lahirunirmalx/astable-multivibrator/docs/check_schematic_report.md

# check-schematic report - astable_multivibrator (2026-10-20)

Input: `kicad/astable_multivibrator/astable_multivibrator.kicad_sch` (generated by draw-schematic pipeline, ok=True)
Analysis dir: `analysis/2026-10-20_1046/`

## Checklist

```
--- check-schematic ran ---
OK  ERC (kicad-cli)            0 errors / 0 warnings (after project fp/sym lib tables)
OK  draw-schematic L3 topology 12 / 12 nets match the .py source (40 pin nodes)
OK  analyze_schematic          findings: BLOCKER 0 / CRITICAL 0 / HIGH 0 / error 1 (SS-001) / warning 1 (RS-001) / info 13
OK  simulate_subcircuits       pass 4 / warn 0 / fail 0 / skip 0  (RC networks only; tool does not model the astable)
OK  aa_filter_sim              0 candidates (no ADC chain in this design)
OK  full-circuit ngspice       docs/astable_fullcircuit.cir (generic 2N3904-class model, red LED model)
SKIP Monte Carlo               not requested
SKIP datasheet pin-level       no MPN chosen on purpose (jellybean build); hybrid footprint pad map checked by hand instead
--- verdict ---
pass  next: draw-pcb (Phase 4)
```

## Findings triage

| rule | severity | what | decision |
|---|---|---|---|
| SS-001 | error | 0 of 7 BOM lines carry an MPN | accepted by design: every line is a generic value-only part (R, C, LED, GP NPN, pin header, copper jumper). Section 5 of CLAUDE.md records the spec per role. Not a fab blocker for a hobby board; production assembly would need MPNs. |
| RS-001 | warning | VCC has no PWR_FLAG / source pin | J1 is a passive 1x2 header; ERC itself is clean. No action. |
| PL-001 | info | Q1/Q2 drive LEDs without sense resistor | R1/R4 (470 R) are the current limit; the detector expected a PWM dimmer topology. No action. |
| SJ-DET x4 | info | solder jumpers detected | expected (pinout select). |
| TR-DET x2, RC-DET x2, LA-AUD x2, DS-003 | info | structure detected | expected. |

## Full-circuit transient (ngspice 1 ms step, 4 s)

| supply | period | freq | LED peak current | base negative swing | note |
|---|---|---|---|---|---|
| 5 V | 0.545 s | 1.83 Hz | 7.0 mA | -2.9 V | within V_EBO of any GP NPN |
| 9 V | 0.590 s | 1.70 Hz | 15.3 mA | -6.9 V (model has no E-B breakdown) | real part avalanches at about -6 V each half cycle; classic-kit behaviour, LED current stays under 20 mA |

Analytic check: half period = Rb * C * ln((Vcc + Vswing) / (Vcc - 0.7)) with Vswing = Vcc - Vf_LED - Vce_sat
(5 V: 47k * 10u * ln(7.3 / 4.3) = 0.249 s -> 0.50 s period; sim 0.545 s, within model tolerance).
The frequency is lower than the textbook 1.386 * Rb * C value because the LED drop reduces the collector swing.

## Verification gaps (stated, not hidden)

- Transistor and LED SPICE models are generic, not datasheet-derived.
- E-B reverse breakdown is not modelled; the 9 V figures are therefore optimistic on timing.
- No datasheet cross-check (no MPN).
