lahirunirmalx/astable-multivibrator/release/20261020_190434/pcb_fab/gerbers/astable_multivibrator-drill_report.txt

Drill report for astable_multivibrator.kicad_pcb
Created on 2026-10-20T15:34:35+0530

Copper Layer Stackup:
    =============================================================
    L1 :  F.Cu                      front
    L2 :  B.Cu                      back

Drill file 'astable_multivibrator.drl' contains
    plated through holes:
    =============================================================
    T1  0.300mm  0.0118"  (9 holes)
    T2  0.750mm  0.0295"  (6 holes)
    T3  0.800mm  0.0315"  (12 holes)
    T4  0.900mm  0.0354"  (4 holes)
    T5  1.000mm  0.0394"  (2 holes)

    Total plated holes count 33

Not plated through holes are merged with plated holes
    unplated through holes:
    =============================================================

    Total unplated holes count 0
