lahirunirmalx/astable-multivibrator/STATUS.md

# astable_multivibrator — STATUS

> live state；决策见 `CLAUDE.md`（静态）；决定理由见 `_artifacts/decisions/`（按需建）
> 最后更新：2026-10-20

## 阶段进度

| Phase | 状态 | 完成日期 | 关键 artifact |
|---|---|---|---|
| 0 骨架 | ✅ | 2026-10-20 | 本目录 + `CLAUDE.md` 模板 + `STATUS.md` + `.gitignore`（project-init 产出）|
| 1 拓扑 | ✅ | 2026-10-20 | `CLAUDE.md` sections 1-9 (classic astable, hybrid footprints, pinout jumpers) |
| 2 选品 | ✅ (skipped) | 2026-10-20 | all parts generic jellybeans, no shortlist needed |
| 2.5 落资产 | ✅ | 2026-10-20 | `~/tools/PCB-Agent-Teams/lib_external/Hybrid.pretty` + `Hybrid.kicad_sym`; `datasheets/.bom_readiness.json` all_pass (15/15 generic) |
| 3 sch 生成 | ✅ | 2026-10-20 | `kicad/astable_multivibrator/astable_multivibrator.kicad_sch` + .pdf; ERC 0 err / 0 warn, L3 12/12 nets, L4 footprints ok |
| 3.5 sch 检查 | ✅ | 2026-10-20 | `analysis/2026-10-20_1046/` + `docs/check_schematic_report.md` (ngspice 1.8 Hz @ 5 V, 7 mA LED) |
| 4 pcb 生成 | ✅ | 2026-10-20 | `kicad/astable_multivibrator/astable_multivibrator.kicad_pcb` (26.15 x 21.73 mm, Freerouting, GND pour both sides, 7 stitch vias, DRC 0 err / 0 warn / 0 unconnected); placed-only board `astable_multivibrator_placed.kicad_pcb`; panel `kicad/panel/astable_multivibrator_panel.kicad_pcb` (2x4, 110.3 x 59.4 mm, DRC clean) |
| 4.5 pcb 检查 | ✅ | 2026-10-20 | `analysis/2026-10-20_1046/{pcb,cross_analysis,thermal,emc,gerber}.json` + `docs/check_pcb_report.md` (pass, all findings triaged) |
| 5 release | ✅ | 2026-10-20 | `release/20261020_190434/` (release umbrella: fab zip, CPL, assembly BOM, procurement CSVs, ORDER_GUIDE) + `release/astable_multivibrator_gerbers_panel_2x4.zip` + `release/PCBWAY_ORDER.md` (user chose PCBWay, PCB only) |

## 当前 blocker

- user confirmation of CLAUDE.md section 9 assumptions (pinout-jumper reading, hybrid reading, 2x4 panel); then `release` umbrella if a vendor order package is wanted

## 已产出 artifact 索引

- ✅ `CLAUDE.md` 模板（2026-10-20，待 Phase 1 填实）
- ✅ `STATUS.md` 本文件（2026-10-20）
- ✅ `.gitignore`

## Change log（append-only，含回退）

- **2026-10-20**: Phase 0 - project-init skeleton (5 subdirs + .gitignore + CLAUDE.md template + this file)
- **2026-10-20**: Phase 1 - circuit frozen in CLAUDE.md (2N-style astable, 470R/47k/10uF, ~1.5 Hz). Hybrid footprint lib `~/electronics/lib_external/Hybrid.pretty` (4 footprints) + `Hybrid.kicad_sym` (5-pin NPN) generated by `kicad/tools/build_hybrid_footprints.py`; scratch-board DRC: 0 errors.
- **2026-10-20**: Phase 2.5 - check_readiness all_pass (generic mode). Phase 3 - pipeline.py ok=True (ERC 0/0 after project lib tables, L3 topology 12/12). Skill script patches: `verify_topology.py` (kicad-cli path + KiCad 9 netlist parsing), `check_readiness.py` (Device:Q_* / Jumper: / Hybrid: generic classification).
- **2026-10-20**: Phase 3.5 - check-schematic pass (SS-001 no-MPN accepted by design; full-circuit ngspice 1.83 Hz / 7 mA at 5 V, 1.70 Hz / 15 mA at 9 V).
- **2026-10-20**: Phase 4 - draw-pcb loop: 1 placement round (hand plan, mirror-symmetric 3 columns), route-ready 10/10, refit 26.05 x 21.64 mm fill 0.63. Phase E routed with **Freerouting 1.9.0** (user request; new skill tool `draw-pcb/scripts/tools/route_freerouting.py`, now the default engine in SKILL.md). Re-pour (GND,B.Cu)+(GND,F.Cu), 7 stitch vias, silk tidied (`kicad/tools/silk_tidy.py`: outlines crossing SMD lands moved to F.Fab, refs pinned, JP refs on F.Fab). Final DRC 0/0/0. KiKit panel 2x4 (`kicad/panel/`), DRC clean after mouse-bite spacing 1.0 mm / offset 0.
- **2026-10-20**: Phase 4.5 - check-pcb pass (DRC 0/0/0, cross 0, EMC/thermal findings triaged as not applicable at 1.8 Hz). Gerbers + drill + CPL exported for board and 2x4 panel (`release/`), gerber audit GR-004 expected (THT no paste).
- **2026-10-20**: Phase 5 - release umbrella run (channel prefs auto_cheapest / any / stable_first recorded; user's actual fab choice PCBWay documented in release/PCBWAY_ORDER.md). Patched release/scripts/export_gerbers.py: `--check-zones` only on kicad-cli >= 10. Project symlinked into ~/tools/PCB-Agent-Teams/Projects/. Independent fab-artifact review launched (see docs/release_review.md).
- **2026-10-21**: v2 added (`kicad/astable_v2_single_layer/`): single-sided home-etch board, 62 x 72 mm, THT only, 1.0 mm tracks / 0.6 mm clearance, 2x3 header selection of Rb (22k/47k/100k) and C (4.7u/10u/47u) per stage, pinout select on 1x3 headers, 3 wire links (net-tie footprints, series sub-nets GND_W1 / GND_W2 / Q1_B_W3). New lib `kicad/lib/HomeEtch.pretty` + `AstableV2.kicad_sym`; generators `gen_v2_schematic.py`, `gen_v2_board.py`, `route_v2.py` (Freerouting with F.Cu rule area), `finalize_v2.py`. ERC 0/0, DRC 0 errors / 0 unconnected (silk warnings ignored by project rules), compare_netlist 82/82. ngspice 3x3 sweep in `docs/spice/`, CircuitJS link in `docs/circuitjs/`. Guide `docs/v2_home_etching.md`.
- **2026-10-21**: Hobby release prep. Hybrid lib vendored into `kicad/lib/` (lib tables now `${KIPRJMOD}/../lib/`), KiCad 3D models attached to the hybrid footprints (`kicad/tools/add_3d_models.py`), board footprints given the `Hybrid:` nickname. Schematic re-laid as a classic wired drawing (`kicad/tools/layout_schematic.py`, same symbol UUIDs, VCC/GND now power symbols + PWR_FLAG; board nets `/VCC` `/GND` renamed `VCC` `GND`, netclass patterns updated). Verified: ERC 0/0, DRC 0 errors + 10 `lib_footprint_mismatch` warnings (intentional silk-tidy local overrides), `compare_netlist.py` 40/40 pins match. Panel regenerated from the updated board; `kicad/panel/` now carries the lib tables too (DRC 0 errors / 80 `lib_footprint_mismatch` = 8 boards x the same 10 silk-tidy warnings). Renders in `images/`, STEP in `release/`, README + LICENSE (MIT) + docs/assembly.md rewritten. Release gerbers untouched (copper unchanged; their X2 net attributes still say `/VCC` `/GND`).
- **2026-10-20**: Phase 2 skipped (generic parts). Env: `~/.venv` and `~/lib_external` symlinked to `~/electronics/`; `verify_topology.py` and `check_readiness.py` skill scripts patched for Linux / generic symbols.

## 图例

| 符号 | 含义 |
|---|---|
| ✅ | done — phase 完成 + gate 通过 |
| 🟡 | in progress |
| ⛔ | pending — 还没开始 |
| ⚠ | stale — 上游改了，需重跑 |
| 🔄 | redoing — 用户回退中 |

## 回退处理 cheat sheet

用户喊 "Phase X 回退" 时按以下处理：

1. Phase X 当前行 append 一行 🔄 redoing（**不删历史**）
2. Phase X+1, X+2, ... 所有 ✅ 改成 ⚠ stale
3. 关联 sentinel 文件由下次 skill 跑时覆盖
4. 已存在的 .kicad_sch / .kicad_pcb 让 user 决定 git restore 还是覆盖
5. 在 Change log 新加一行说明回退原因
