lahirunirmalx/astable-multivibrator/release/20261020_190434/coverage_matrix.md

# Distributor 覆盖率矩阵
> 生成于 2026-10-20 19:04 JST
> 数据源：（无数据）

## 单 vendor 全覆盖

| Vendor | 覆盖率 | 推荐 |
|---|---|---|
| DigiKey JP | 0/0 | — |
| Mouser JP | 0/0 | — |
| LCSC | 0/0 | — |

## 详细矩阵

| MPN | Qty | Refs | DigiKey JP | Mouser JP | LCSC |
|---|---|---|---|---|---|

> ★ = component-preparing 选定的 primary winner（写进 `phase2.5_v1` evidence）
