lahirunirmalx/astable-multivibrator/images/v2/pcb_3d_bottom.png

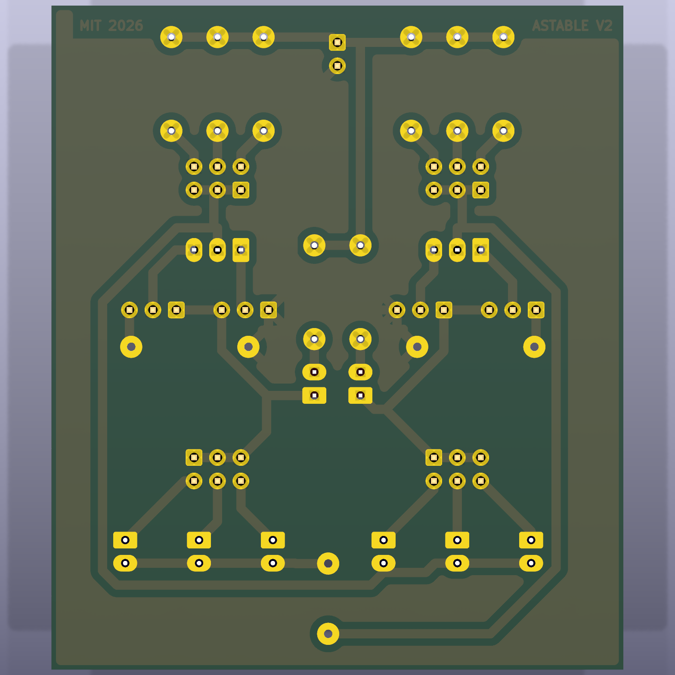
images/v2/pcb_3d_bottom.png
