lahirunirmalx/astable-multivibrator/images/v2/pcb_3d_top.png

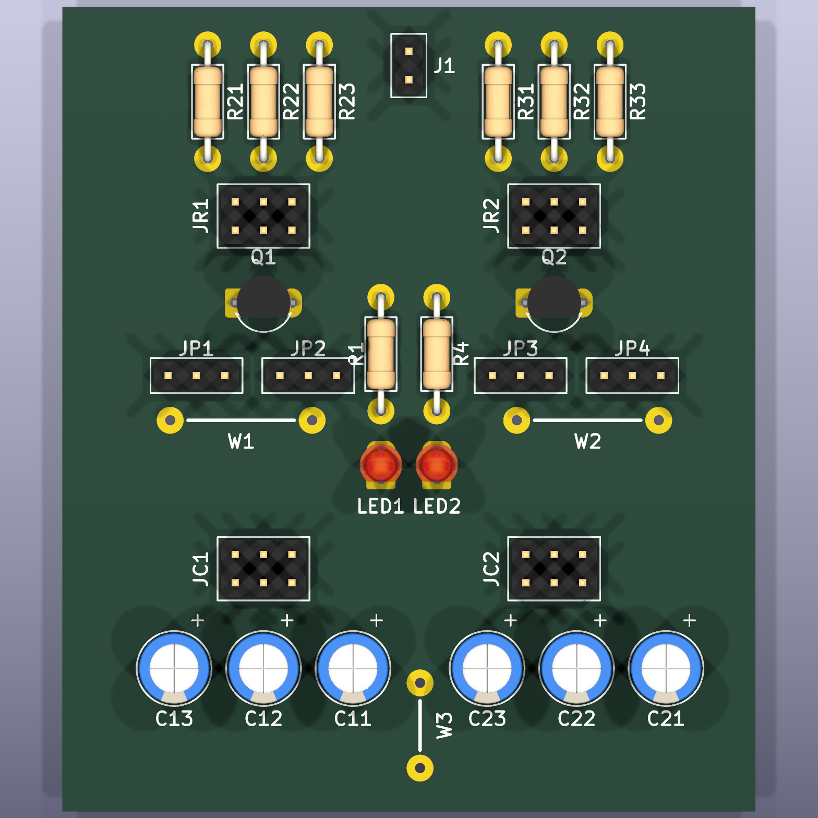
images/v2/pcb_3d_top.png
