lahirunirmalx/astable-multivibrator/images/v2/schematic.png

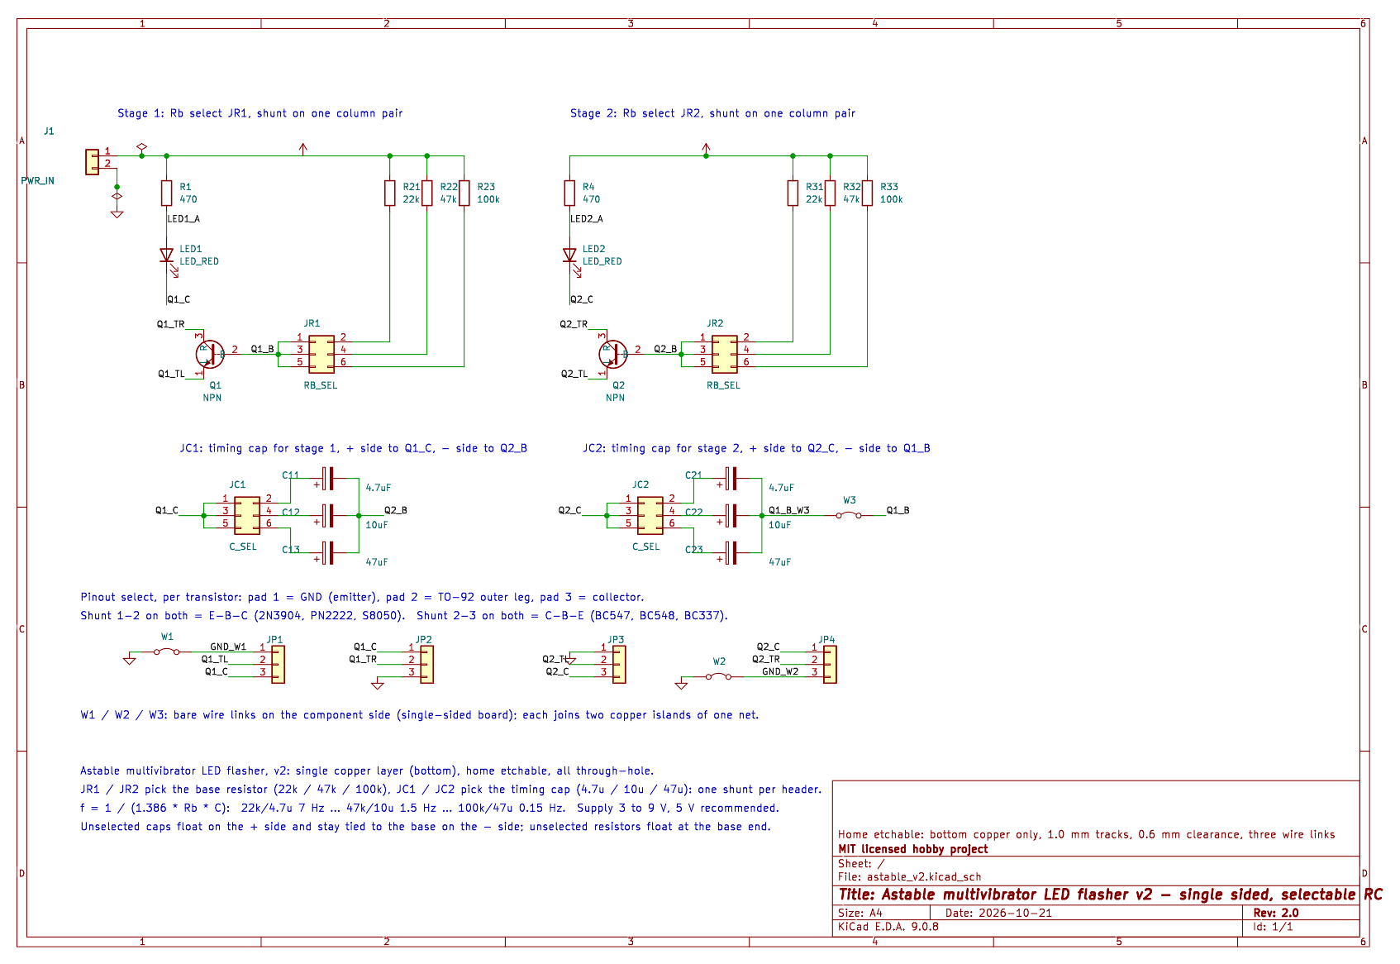
images/v2/schematic.png
