lahirunirmalx/astable-multivibrator/release/astable_multivibrator.step

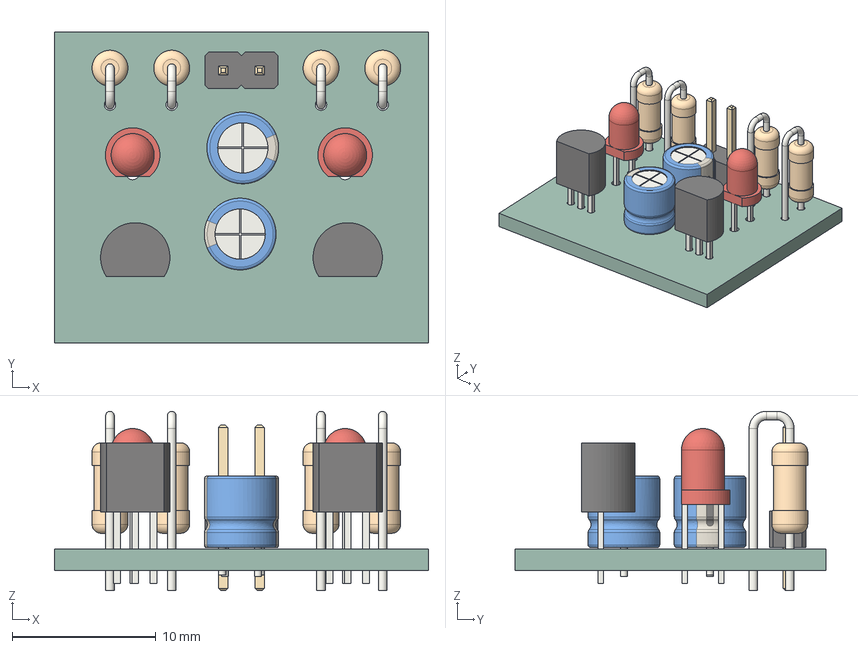
[picture p13: CAD file, 2026-10-21]
release/astable_multivibrator.step
26.0 x 21.6 x 12.5 mm
CP_Radial_D5.0mm_P2.50mm x 2
R_Axial_DIN0207_L6.3mm_D2.5mm_P2.54mm_Vertical x 4
PinHeader_1x02_P2.54mm_Vertical
LED_D3.0mm x 2
TO-92_Inline x 2
astable_multivibrator_PCB
