lahirunirmalx/astable-multivibrator/release/v2/astable_v2.step

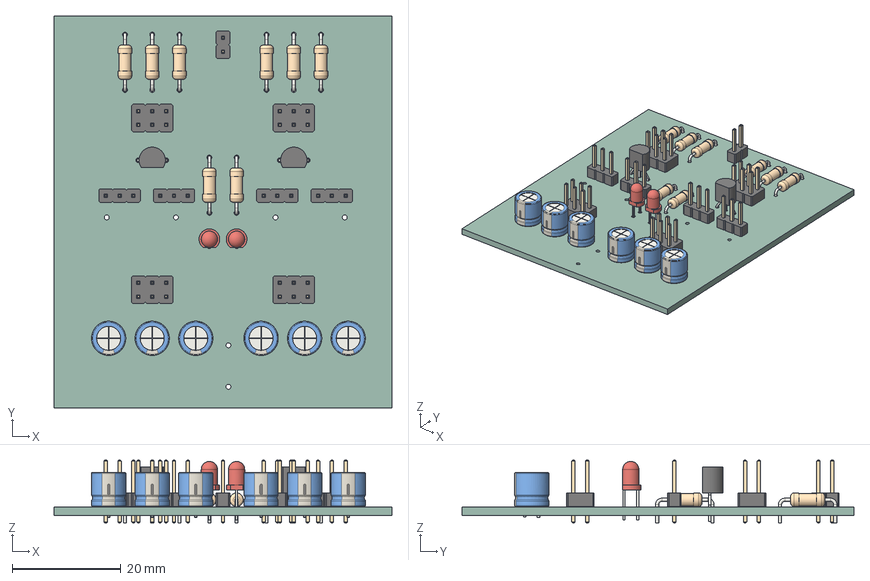
[picture p14: CAD file, 2026-10-21]
release/v2/astable_v2.step
62.0 x 72.0 x 11.5 mm
TO-92_Inline_Wide x 2
PinHeader_1x03_P2.54mm_Vertical x 4
PinHeader_2x03_P2.54mm_Vertical x 4
CP_Radial_D6.3mm_P2.50mm x 6
R_Axial_DIN0207_L6.3mm_D2.5mm_P10.16mm_Horizontal x 8
PinHeader_1x02_P2.54mm_Vertical
LED_D3.0mm x 2
astable_v2_PCB
