lahirunirmalx/astable-multivibrator/images/v2/assembly_top.png

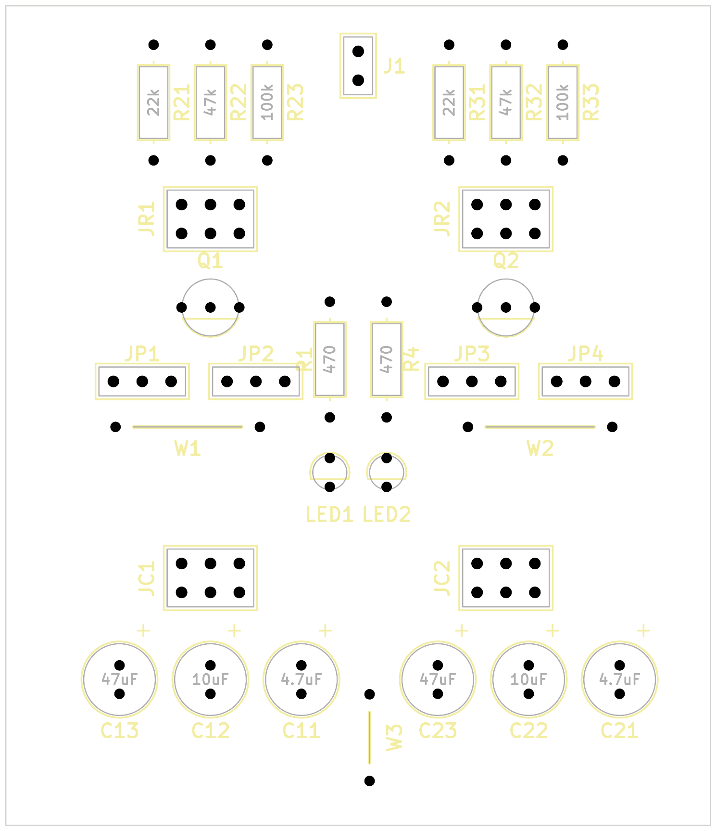
images/v2/assembly_top.png
