lahirunirmalx/astable-multivibrator/docs/astable_v2_schematic.pdf

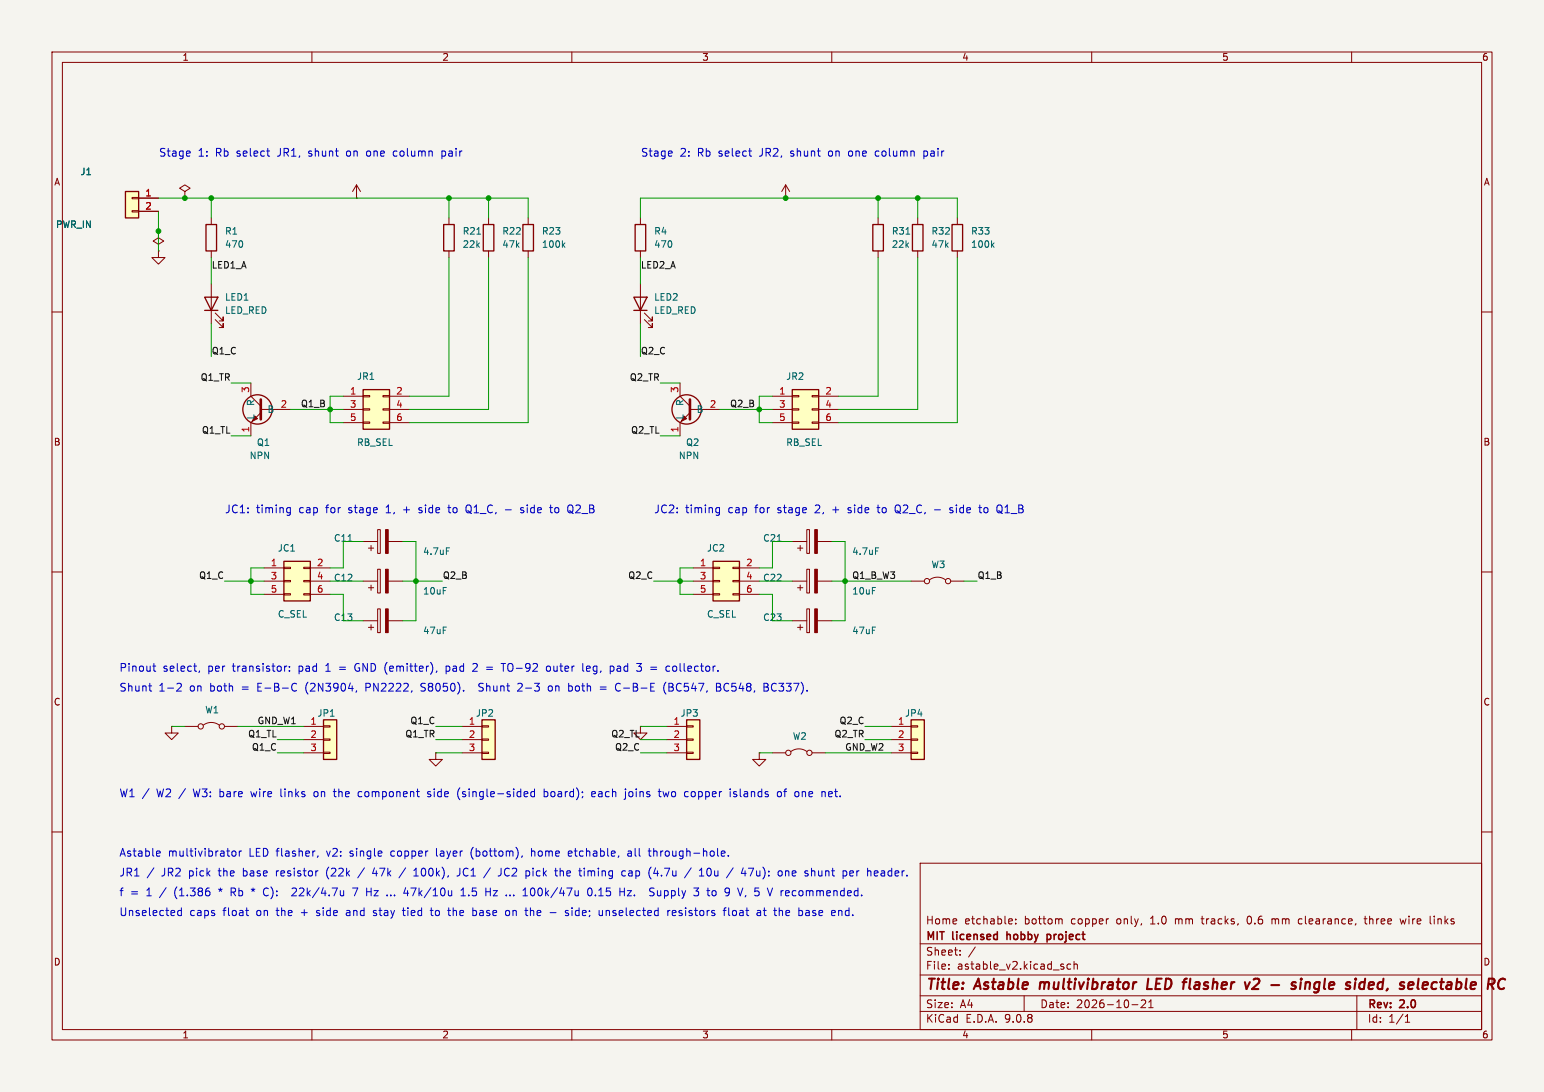
[picture p16: page 1]

Stage 2: Rb select JR2, shunt on one column pair JC2: timing cap for stage 2, + side to Q2_C, - side to Q1_B

JC1: timing cap for stage 1, + side to Q1_C, - side to Q2_B
