lahirunirmalx/astable-multivibrator/docs/astable_multivibrator_schematic.pdf

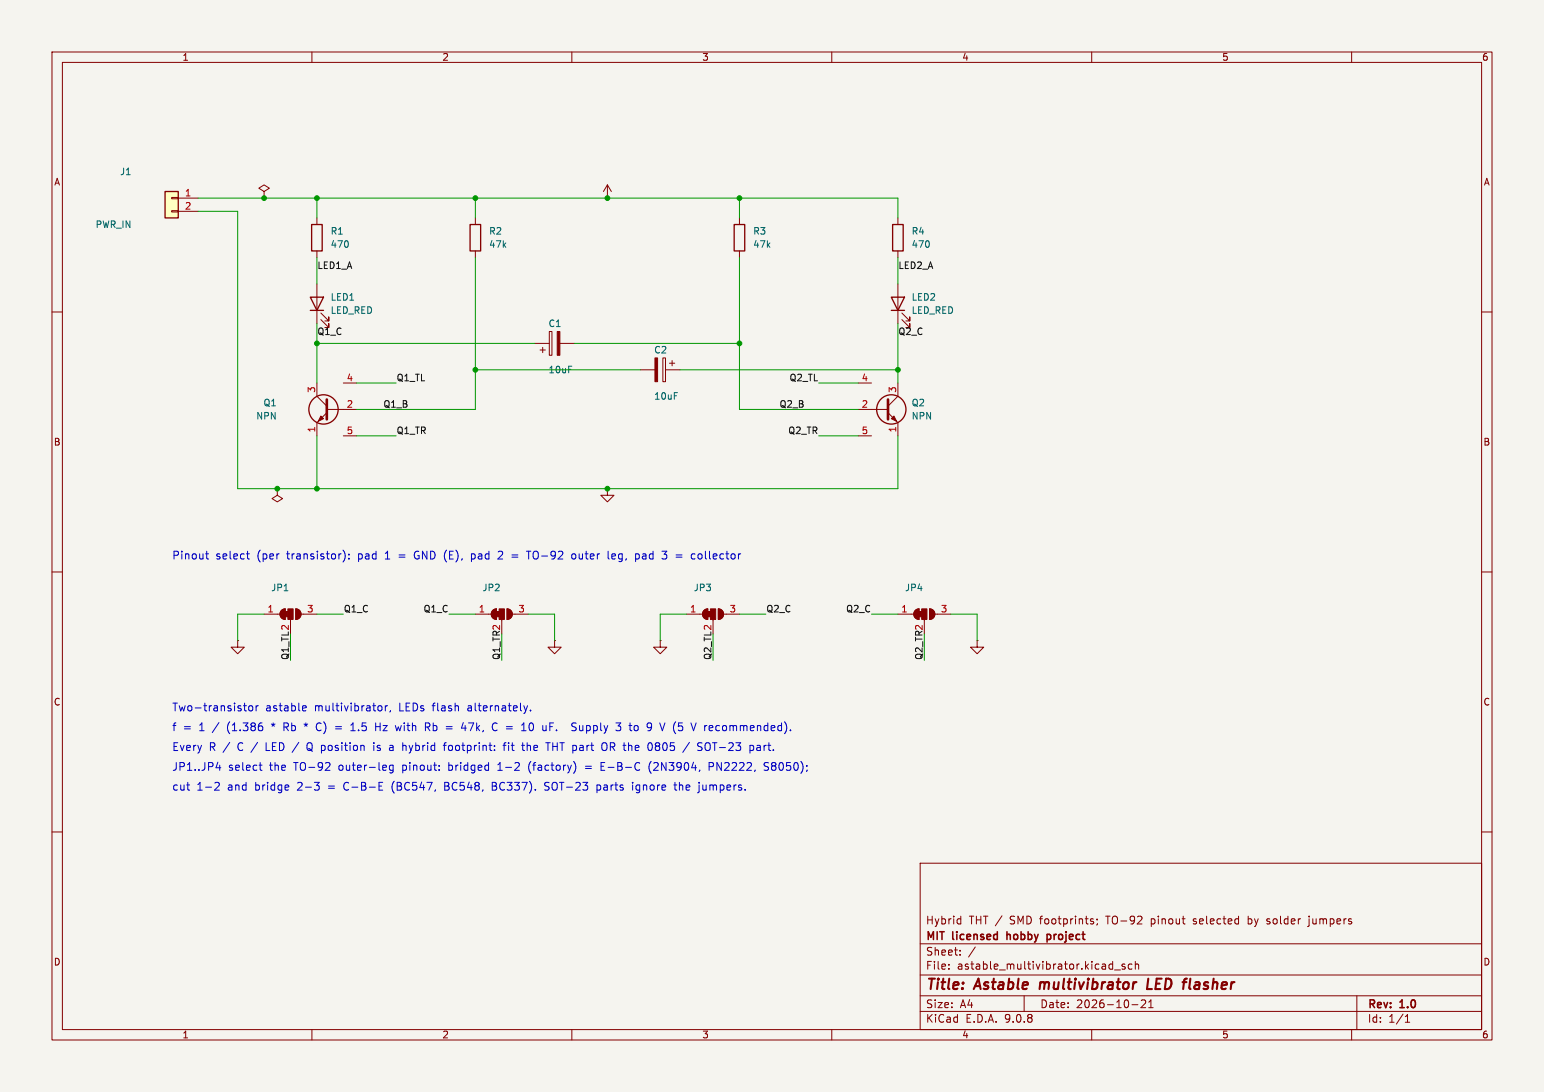
[picture p17: page 1]
