lahirunirmalx/astable-multivibrator/release/v2/astable_v2_assembly_top.pdf

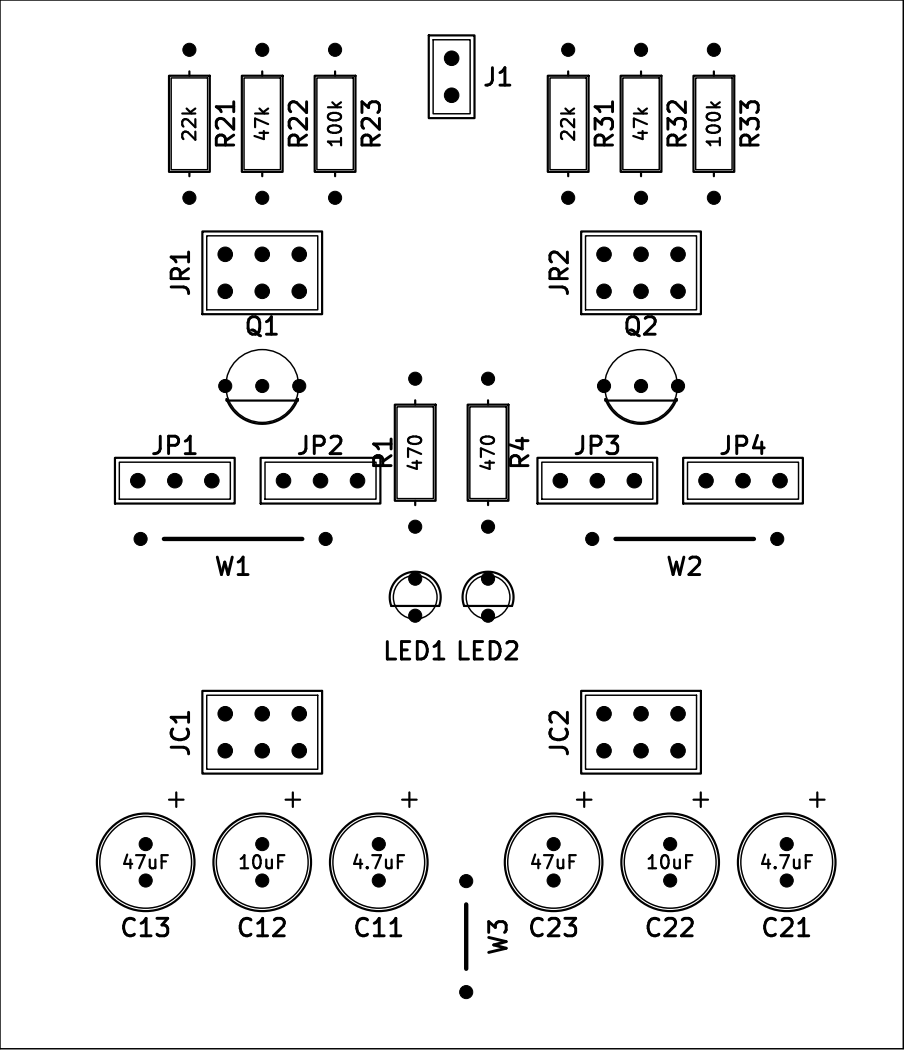
[picture p18: page 1]
