lahirunirmalx/astable-multivibrator/release/v2/astable_v2_copper_toner_transfer_print_as_is.pdf

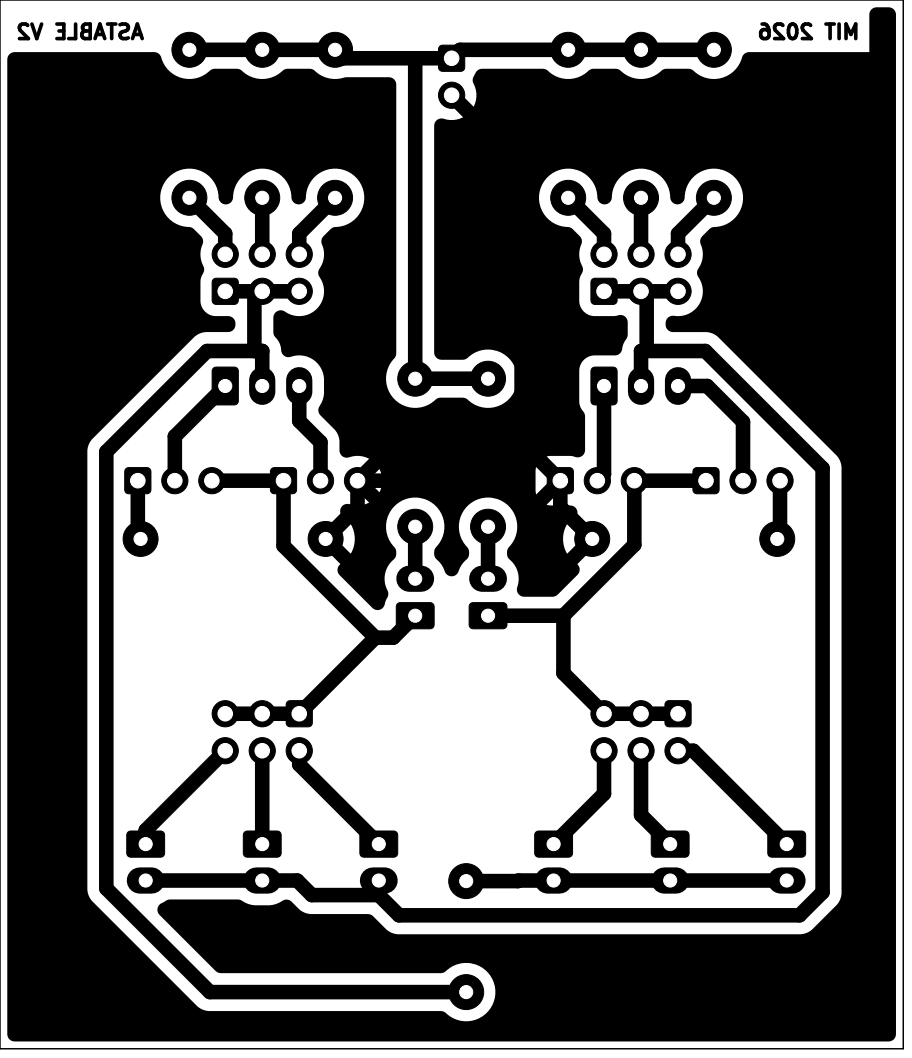
[picture p19: page 1]
