lahirunirmalx/astable-multivibrator/release/v2/astable_v2_copper_mirrored_for_photoresist.pdf

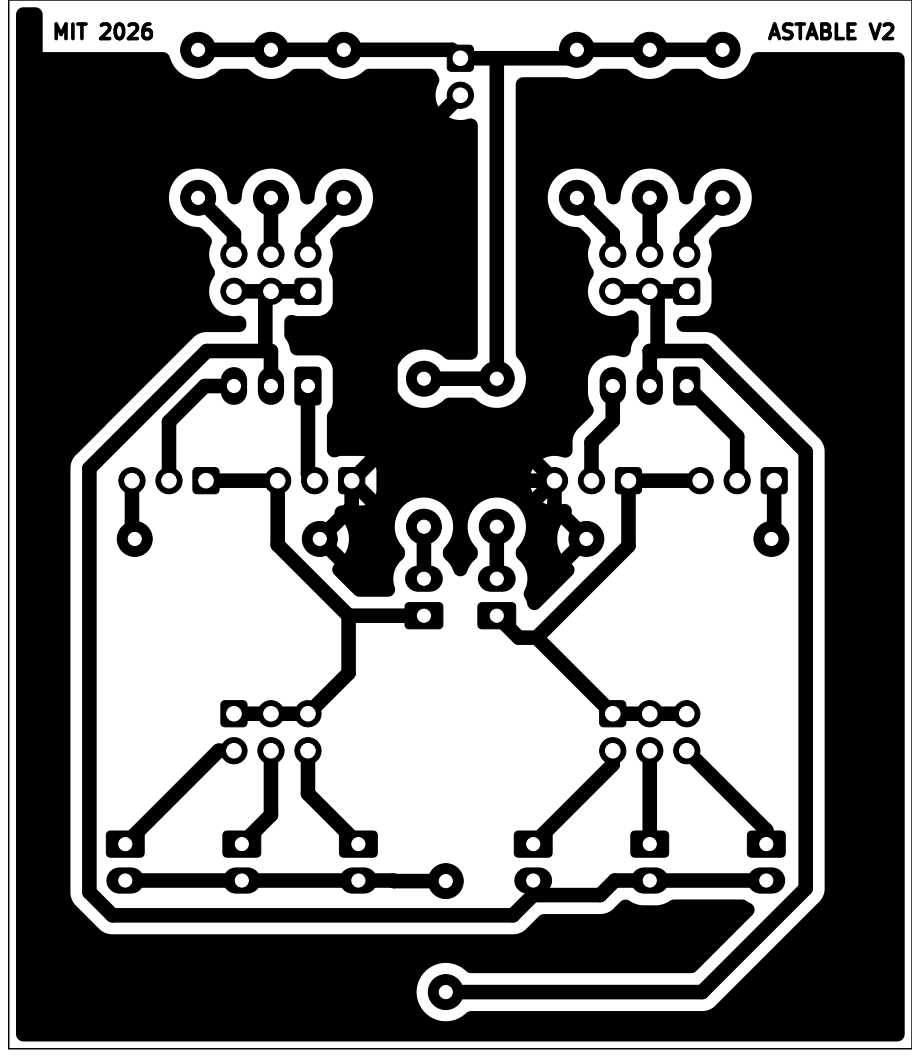
[picture p20: page 1]
