lahirunirmalx/astable-multivibrator/kicad/astable_v2_single_layer/astable_v2.kicad_pcb

## KiCad design kicad/astable_v2_single_layer/astable_v2.kicad_pcb (2026-10-21)

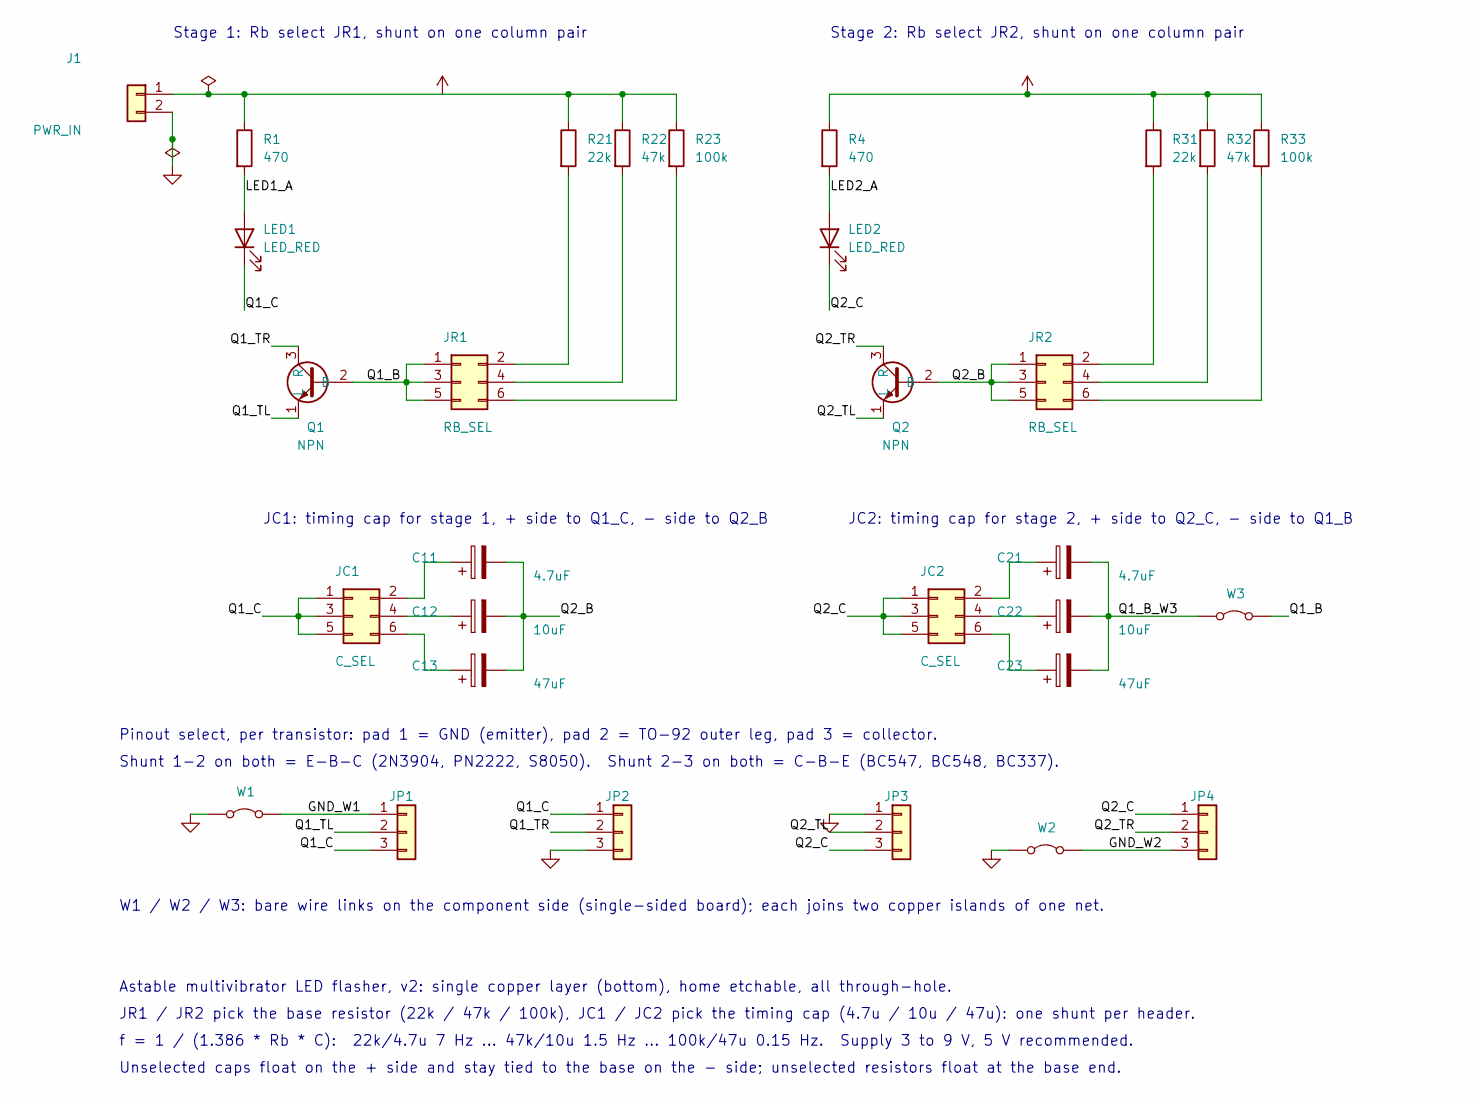
[picture p21: schematic astable_v2.kicad_sch, Astable multivibrator LED flasher v2 - single sided, select…]

Parts:
C11, C21: 4.7uF; CP_Radial_D6.3mm_P2.50mm_HomeEtch
C12, C22: 10uF; CP_Radial_D6.3mm_P2.50mm_HomeEtch
C13, C23: 47uF; CP_Radial_D6.3mm_P2.50mm_HomeEtch
J1: PWR_IN; PinHeader_1x02_P2.54mm_HomeEtch
JC1, JC2: C_SEL; PinHeader_2x03_P2.54mm_HomeEtch
JP1, JP2, JP3, JP4: PINOUT; PinHeader_1x03_P2.54mm_HomeEtch
JR1, JR2: RB_SEL; PinHeader_2x03_P2.54mm_HomeEtch
LED1, LED2: LED_RED; LED_D3.0mm_P2.54mm_HomeEtch
Q1, Q2: NPN; TO-92_P2.54mm_HomeEtch
R1, R4: 470; R_Axial_P10.16mm_HomeEtch
R21, R31: 22k; R_Axial_P10.16mm_HomeEtch
R22, R32: 47k; R_Axial_P10.16mm_HomeEtch
R23, R33: 100k; R_Axial_P10.16mm_HomeEtch
W1, W2: WIRE_LINK; WireLink_P12.70mm_HomeEtch
W3: WIRE_LINK; WireLink_P7.62mm_HomeEtch

Connections:
/GND_W1: JP1.1, W1.2 (B)
/GND_W2: JP4.3, W2.2 (B)
/LED1_A: LED1.2 (A), R1.2
/LED2_A: LED2.2 (A), R4.2
/Q1_B: JR1.1, JR1.3, JR1.5, Q1.2 (B), W3.2 (B)
/Q1_B_W3: C21.2, C22.2, C23.2, W3.1 (A)
/Q1_C: JC1.1, JC1.3, JC1.5, JP1.3, JP2.1, LED1.1 (K)
/Q1_TL: JP1.2, Q1.1 (L)
/Q1_TR: JP2.2, Q1.3 (R)
/Q2_B: C11.2, C12.2, C13.2, JR2.1, JR2.3, JR2.5, Q2.2 (B)
/Q2_C: JC2.1, JC2.3, JC2.5, JP3.3, JP4.1, LED2.1 (K)
/Q2_TL: JP3.2, Q2.1 (L)
/Q2_TR: JP4.2, Q2.3 (R)
GND: J1.2, JP2.3, JP3.1, W1.1 (A), W2.1 (A)
unnamed: C11.1, JC1.2
unnamed: C12.1, JC1.4
unnamed: C13.1, JC1.6
unnamed: C21.1, JC2.2
unnamed: C22.1, JC2.4
unnamed: C23.1, JC2.6
unnamed: JR1.2, R21.2
unnamed: JR1.4, R22.2
unnamed: JR1.6, R23.2
unnamed: JR2.2, R31.2
unnamed: JR2.4, R32.2
unnamed: JR2.6, R33.2
VCC: J1.1, R1.1, R4.1, R21.1, R22.1, R23.1, R31.1, R32.1, R33.1

Notes on the sheet:
Stage 1: Rb select JR1, shunt on one column pair
Stage 2: Rb select JR2, shunt on one column pair
JC1: timing cap for stage 1, + side to Q1_C, - side to Q2_B
JC2: timing cap for stage 2, + side to Q2_C, - side to Q1_B
Pinout select, per transistor: pad 1 = GND (emitter), pad 2 = TO-92 outer leg, pad 3 = collector.
Shunt 1-2 on both = E-B-C (2N3904, PN2222, S8050). Shunt 2-3 on both = C-B-E (BC547, BC548, BC337).
W1 / W2 / W3: bare wire links on the component side (single-sided board); each joins two copper islands of one net.
Astable multivibrator LED flasher, v2: single copper layer (bottom), home etchable, all through-hole.
JR1 / JR2 pick the base resistor (22k / 47k / 100k), JC1 / JC2 pick the timing cap (4.7u / 10u / 47u): one shunt per header.
f = 1 / (1.386 * Rb * C): 22k/4.7u 7 Hz ... 47k/10u 1.5 Hz ... 100k/47u 0.15 Hz. Supply 3 to 9 V, 5 V recommended.
Unselected caps float on the + side and stay tied to the base on the - side; unselected resistors float at the base end.

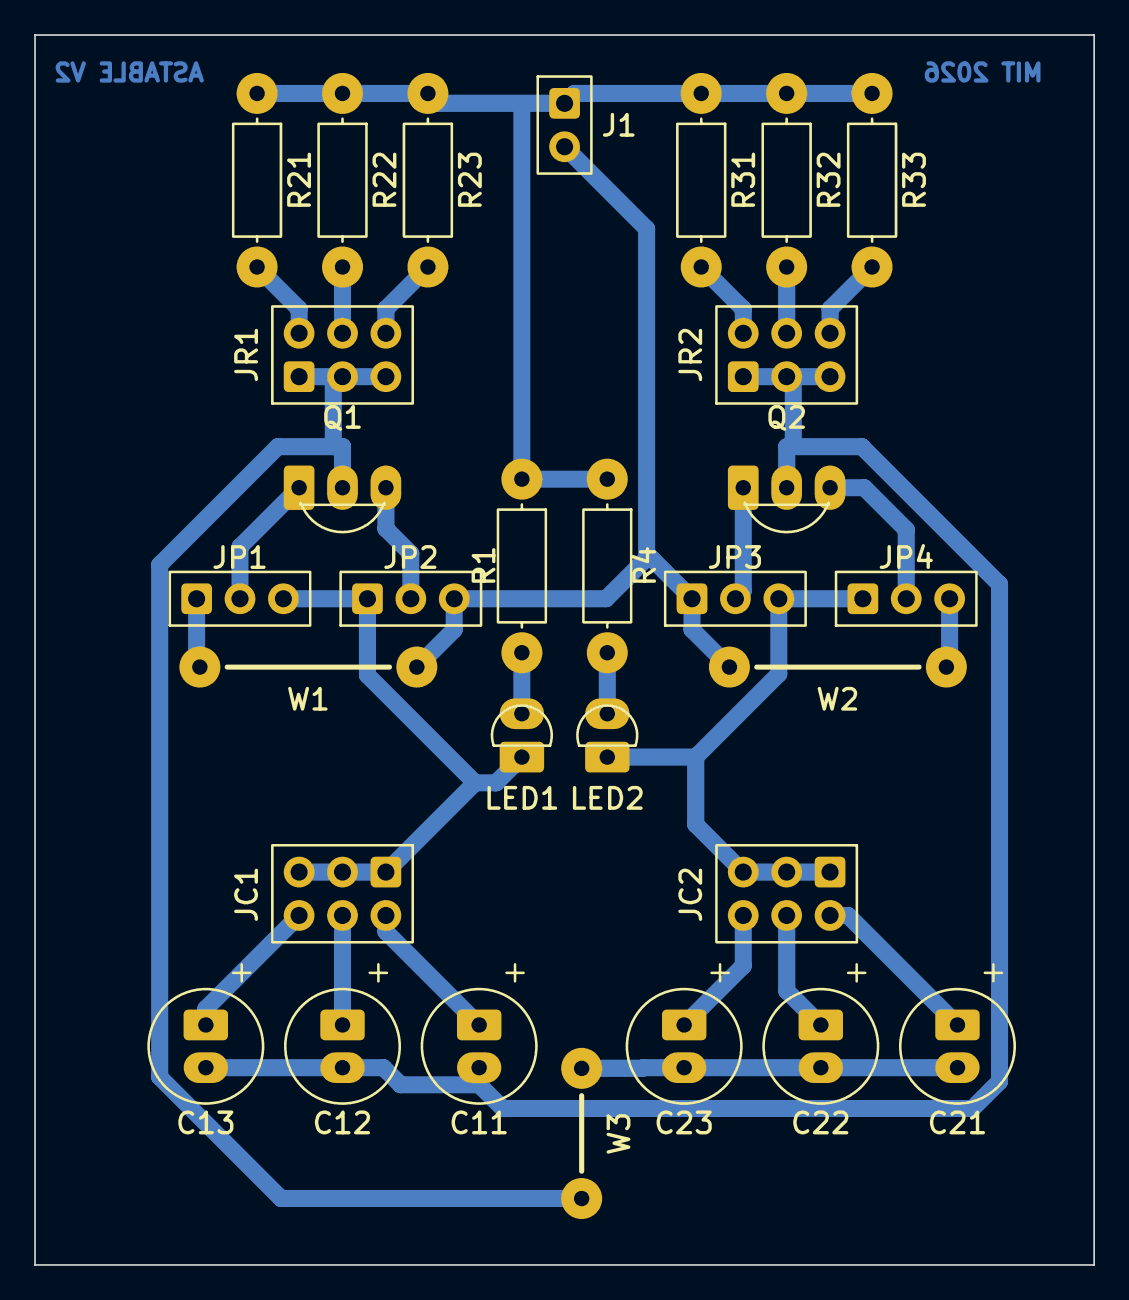
[picture p22: board astable_v2.kicad_pcb from above]

Board: 2 copper layers, 62.0 x 72.0 mm, 30 parts (0 on the bottom side), 27 nets.
