lahirunirmalx/astable-multivibrator/kicad/astable_multivibrator/astable_multivibrator.kicad_pcb

## KiCad design kicad/astable_multivibrator/astable_multivibrator.kicad_pcb (2026-10-21)

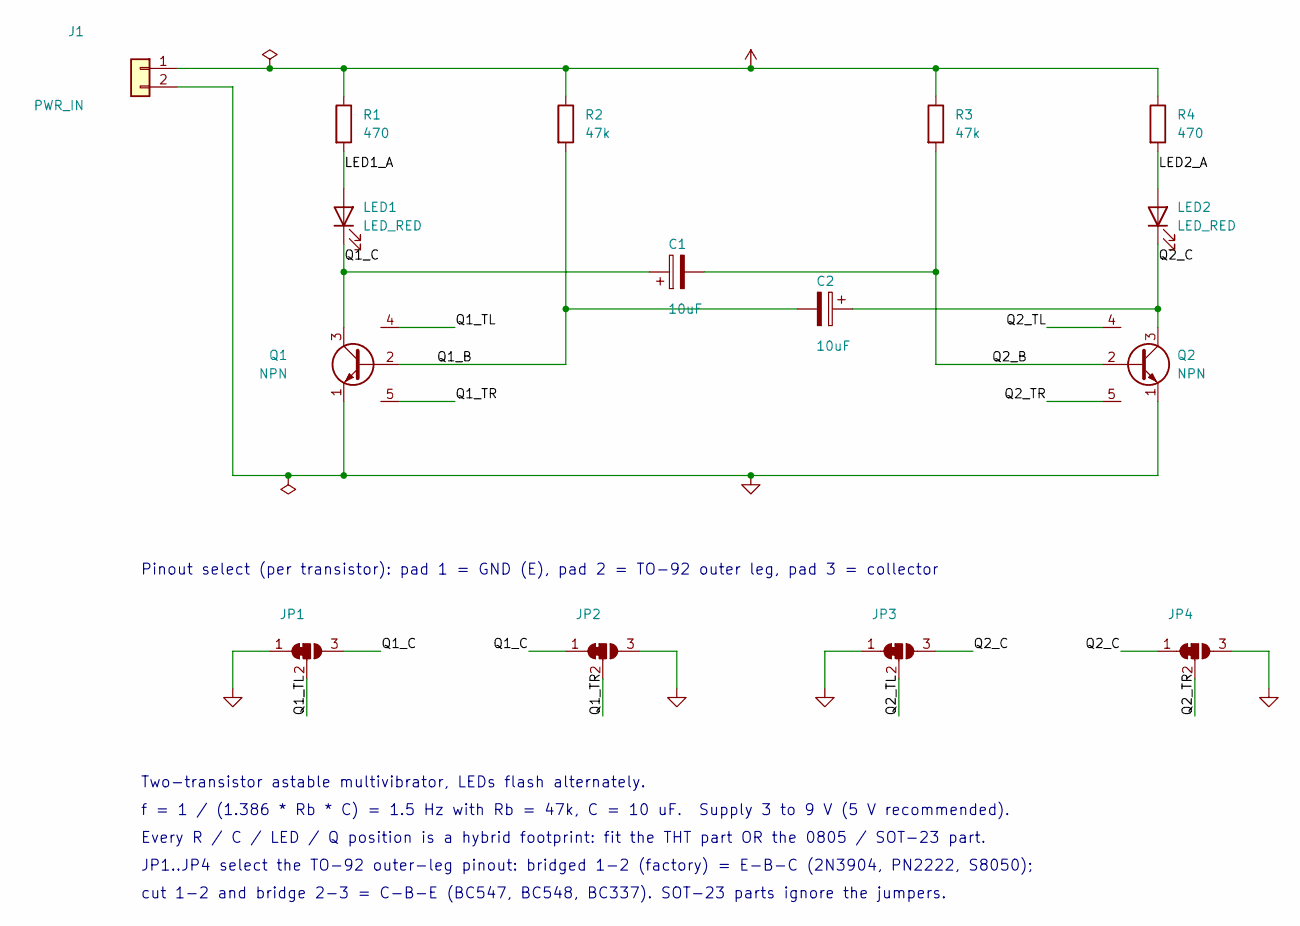
[picture p23: schematic astable_multivibrator.kicad_sch, Astable multivibrator LED flasher]

Parts:
C1, C2: 10uF; CP_Hybrid_0805_D5.0mm_P2.50mm
J1: PWR_IN; PinHeader_1x02_P2.54mm_Vertical
JP1, JP2, JP3, JP4: PINOUT; SolderJumper-3_P1.3mm_Bridged12_RoundedPad1.0x1.5mm
LED1, LED2: LED_RED; LED_Hybrid_0805_D3.0mm
Q1, Q2: NPN; Q_NPN_Hybrid_TO-92_SOT-23
R1, R4: 470; R_Hybrid_0805_P2.54_Vertical
R2, R3: 47k; R_Hybrid_0805_P2.54_Vertical

Connections:
/LED1_A: LED1.2 (A), R1.2
/LED2_A: LED2.2 (A), R4.2
/Q1_B: C2.2, Q1.2 (B), R2.2
/Q1_C: C1.1, JP1.3 (B), JP2.1 (A), LED1.1 (K), Q1.3 (C)
/Q1_TL: JP1.2 (C), Q1.4 (TL)
/Q1_TR: JP2.2 (C), Q1.5 (TR)
/Q2_B: C1.2, Q2.2 (B), R3.2
/Q2_C: C2.1, JP3.3 (B), JP4.1 (A), LED2.1 (K), Q2.3 (C)
/Q2_TL: JP3.2 (C), Q2.4 (TL)
/Q2_TR: JP4.2 (C), Q2.5 (TR)
GND: J1.2, JP1.1 (A), JP2.3 (B), JP3.1 (A), JP4.3 (B), Q1.1 (E), Q2.1 (E)
VCC: J1.1, R1.1, R2.1, R3.1, R4.1

Notes on the sheet:
Two-transistor astable multivibrator, LEDs flash alternately.
f = 1 / (1.386 * Rb * C) = 1.5 Hz with Rb = 47k, C = 10 uF. Supply 3 to 9 V (5 V recommended).
Every R / C / LED / Q position is a hybrid footprint: fit the THT part OR the 0805 / SOT-23 part.
JP1..JP4 select the TO-92 outer-leg pinout: bridged 1-2 (factory) = E-B-C (2N3904, PN2222, S8050);
cut 1-2 and bridge 2-3 = C-B-E (BC547, BC548, BC337). SOT-23 parts ignore the jumpers.
Pinout select (per transistor): pad 1 = GND (E), pad 2 = TO-92 outer leg, pad 3 = collector

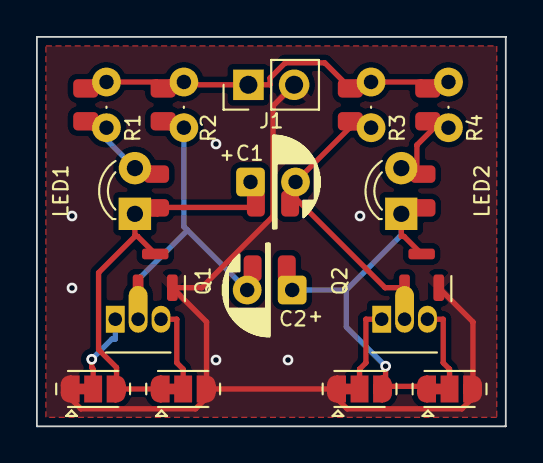
[picture p24: board astable_multivibrator.kicad_pcb from above]

Board: 2 copper layers, 26.0 x 21.6 mm, 15 parts (0 on the bottom side), 12 nets.
