lahirunirmalx/astable-multivibrator/(commit log)

2026-10-21 Astable multivibrator LED flasher: KiCad 9 project, hybrid THT/SMD footprints, gerbers, docs, MIT license
    - Classic two-transistor astable with pinout-select solder jumpers for TO-92 E-B-C / C-B-E and SOT-23
    - Schematic re-laid as a wired drawing; ERC 0/0, DRC 0 errors, schematic vs board 40/40 pins
    - 3D models on the hybrid footprints, renders in images/, STEP and gerber zips in release/
    - README, assembly guide, 2x4 KiKit panel
    [astable_multivibrator-B_Cu.gbl, astable_multivibrator-B_Cu.gbr, astable_multivibrator-B_Mask.gbr, astable_multivibrator-B_Mask.gbs, astable_multivibrator-B_Paste.gbp, astable_multivibrator-B_Paste.gbr, astable_multivibrator-B_Silkscreen.gbo, astable_multivibrator-B_Silkscreen.gbr]
2026-10-21 v2: single-sided home-etch board with selectable RC timing, CircuitJS link
    - kicad/astable_v2_single_layer: bottom copper only, THT, 1.0 mm tracks / 0.6 mm clearance, GND pour
    - 2x3 headers select Rb (22k/47k/100k) and C (4.7u/10u/47u) per stage, 1x3 headers for TO-92 pinout
    - three wire links modelled as series sub-nets on net-tie footprints
    - HomeEtch footprint library, TO-92 socket symbol, generators for schematic, board, routing, finalize
    - ngspice 3x3 sweep, CircuitJS circuit with connectivity audit, home etching guide
    - ERC 0/0, DRC clean with home-etch rules, 82/82 pins schematic vs board
    [astable_v2.kicad_pcb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]
