lahirunirmalx/astable-multivibrator/(notices)

Notices in the files:
kicad/astable_multivibrator/astable_multivibrator.kicad_sch:
MIT licensed hobby project
